Toto1271/RedMachine2025-OFICIAL/v-photos/arriba.jpg

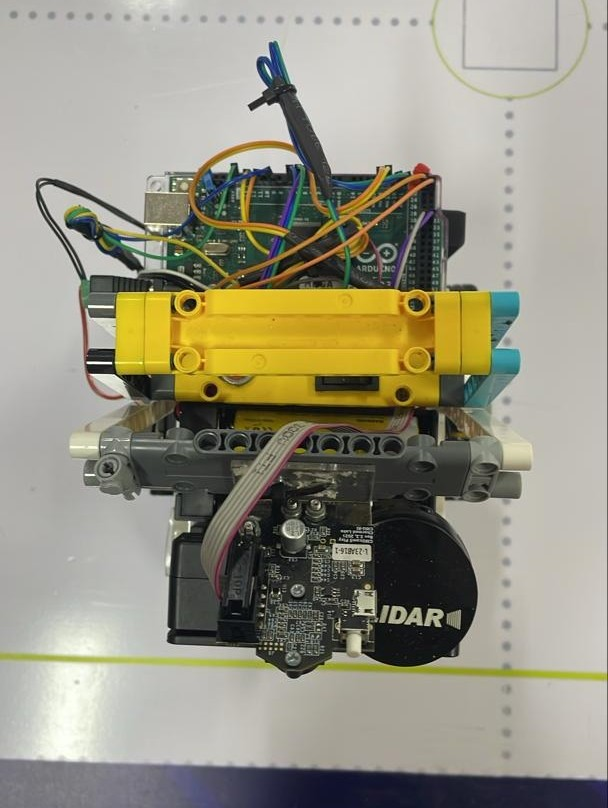
v-photos/arriba.jpg
