Toto1271/RedMachine2025-OFICIAL/v-photos/atras.jpg

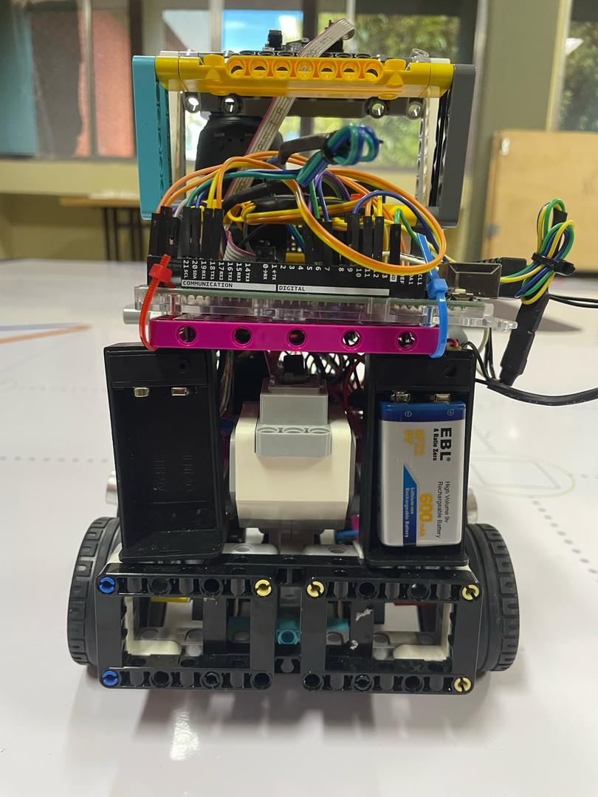
v-photos/atras.jpg
