Toto1271/RedMachine2025-OFICIAL/otros/diagrama de coneccion motores.png

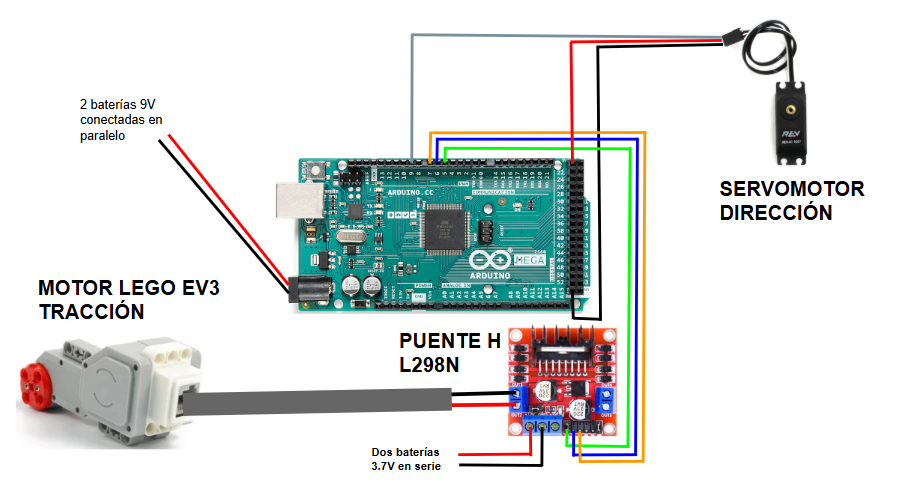
otros/diagrama de coneccion motores.png
