Toto1271/RedMachine2025-OFICIAL/otros/diagrama de coneccion sensores.png

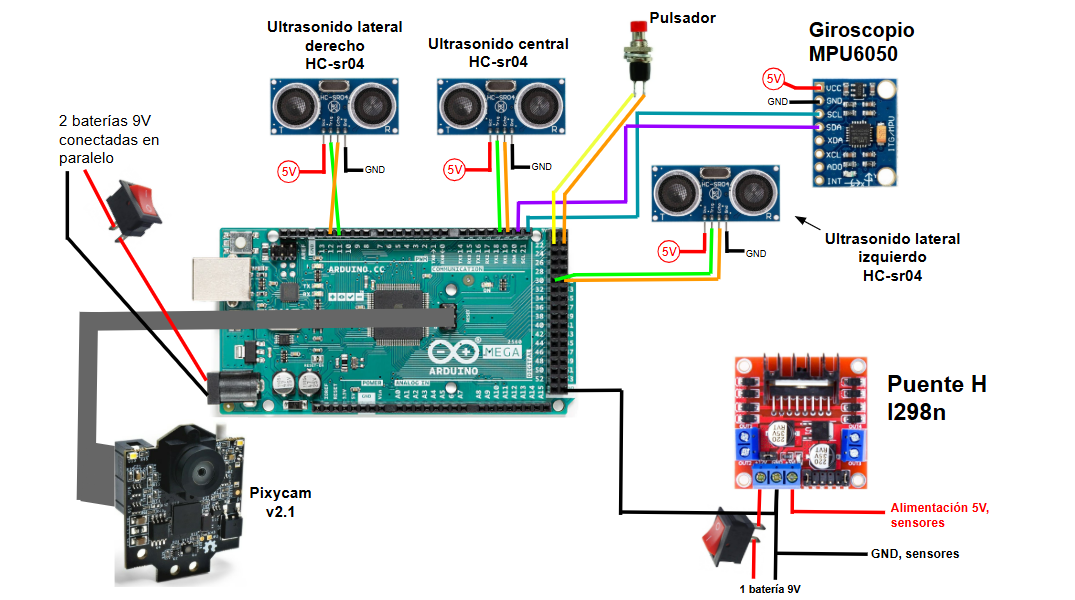
otros/diagrama de coneccion sensores.png
