Toto1271/RedMachine2025-OFICIAL/otros/diagrama pixycam.jpeg

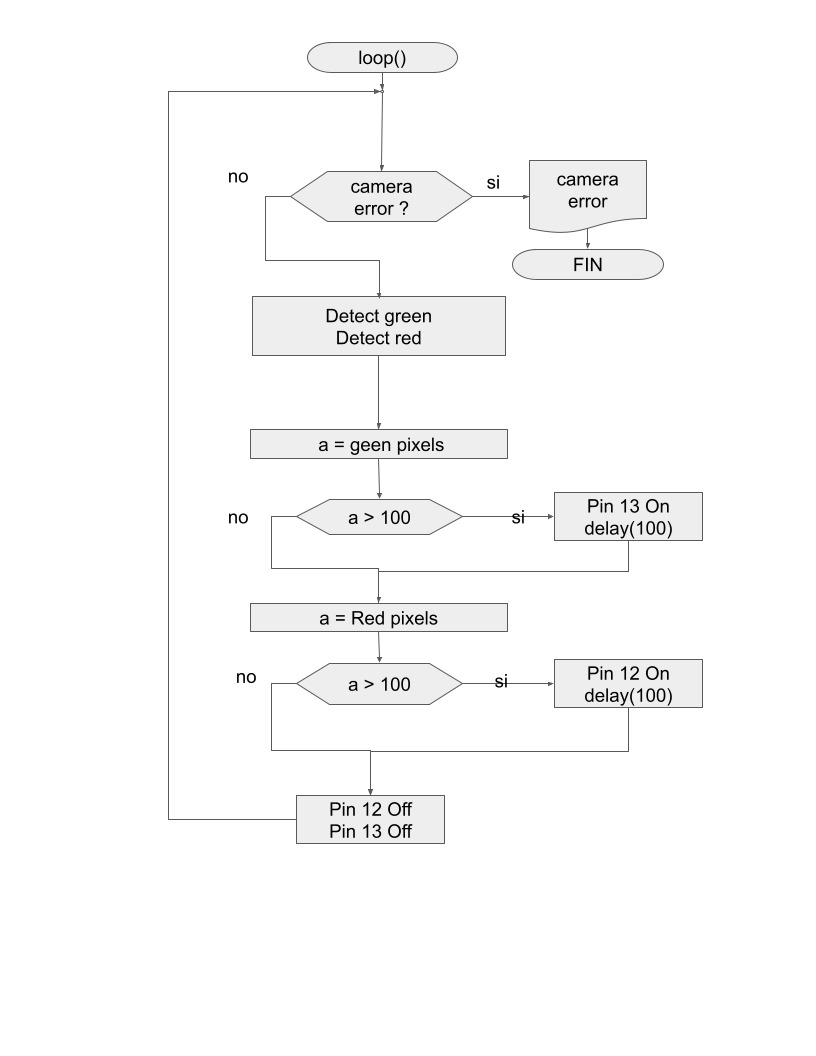
otros/diagrama pixycam.jpeg
