Toto1271/RedMachine2025-OFICIAL/t-photos/2023_Panama_International_final.png

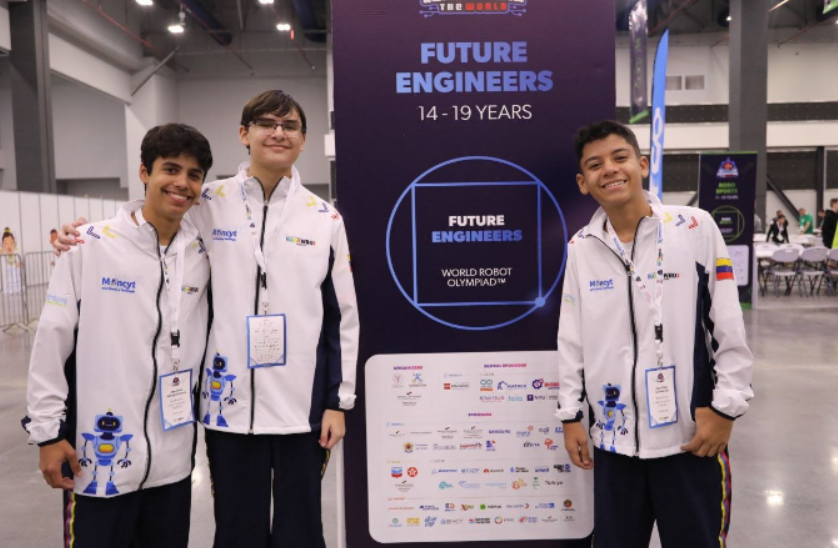
t-photos/2023_Panama_International_final.png
