Toto1271/RedMachine2025-OFICIAL/t-photos/Funny_Foto_2024.jpg

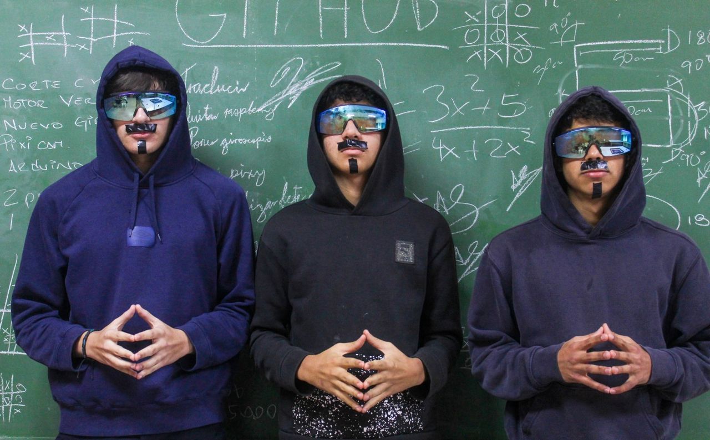
t-photos/Funny_Foto_2024.jpg
