Toto1271/RedMachine2025-OFICIAL/t-photos/Team_photo.png

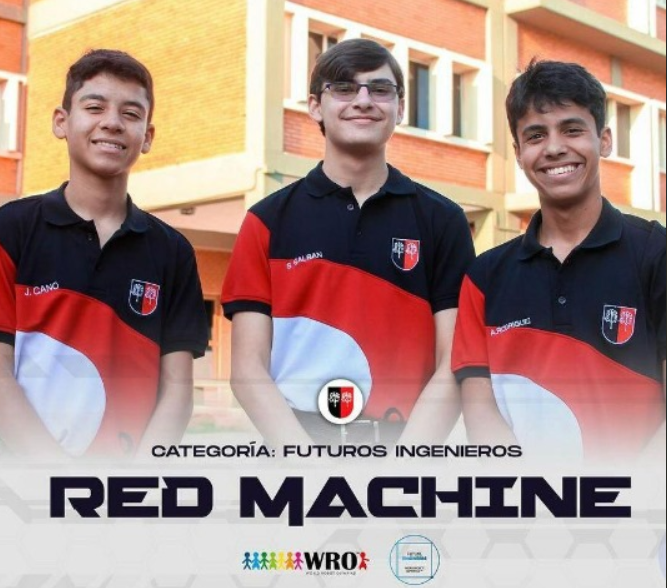
t-photos/Team_photo.png
