Toto1271/RedMachine2025-OFICIAL/v-photos/debajo.jpg

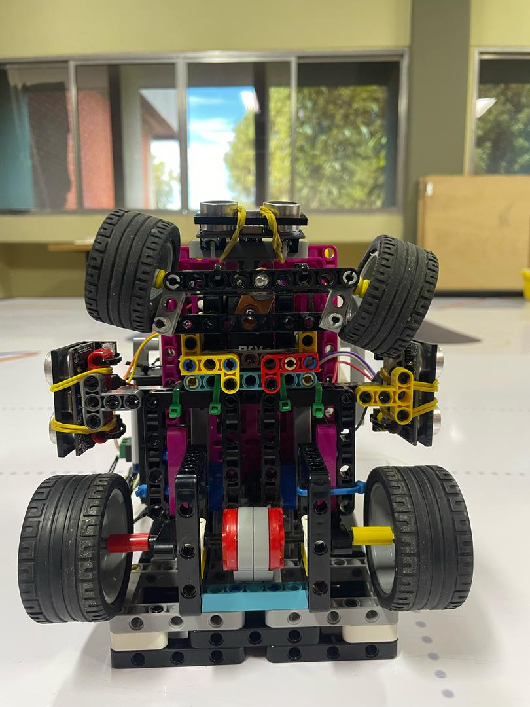
v-photos/debajo.jpg
