Toto1271/RedMachine2025-OFICIAL/v-photos/frontal.jpg

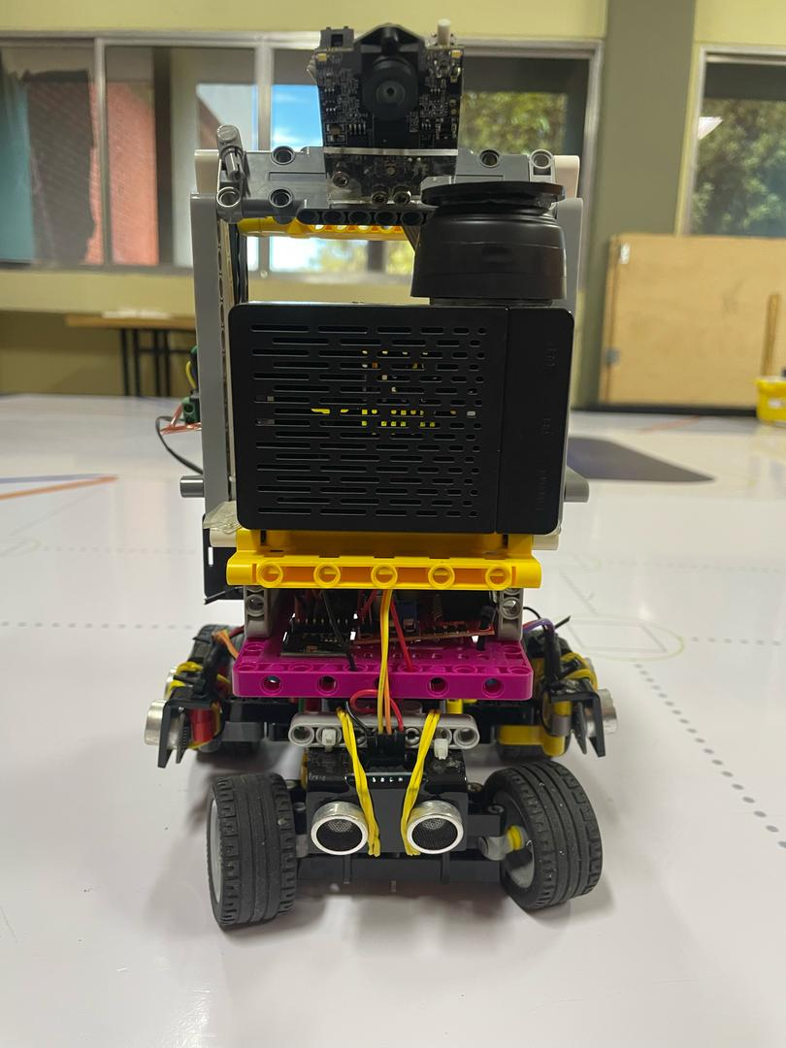
v-photos/frontal.jpg
