Toto1271/RedMachine2025-OFICIAL/v-photos/lateral derecho.jpg

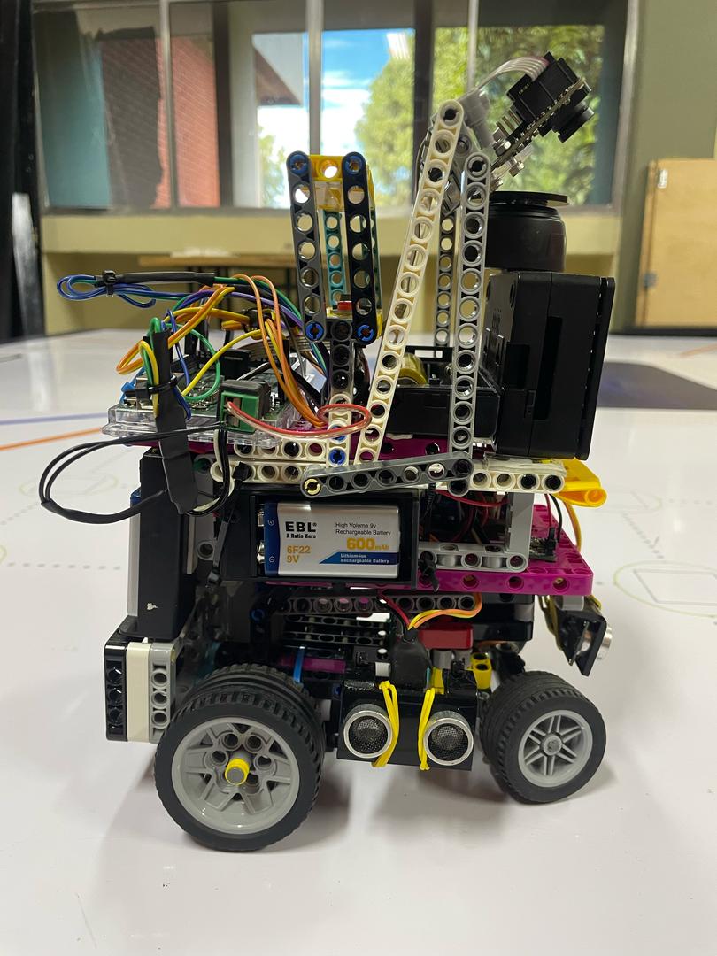
v-photos/lateral derecho.jpg
