Toto1271/RedMachine2025-OFICIAL/v-photos/lateral izquierdo.jpg

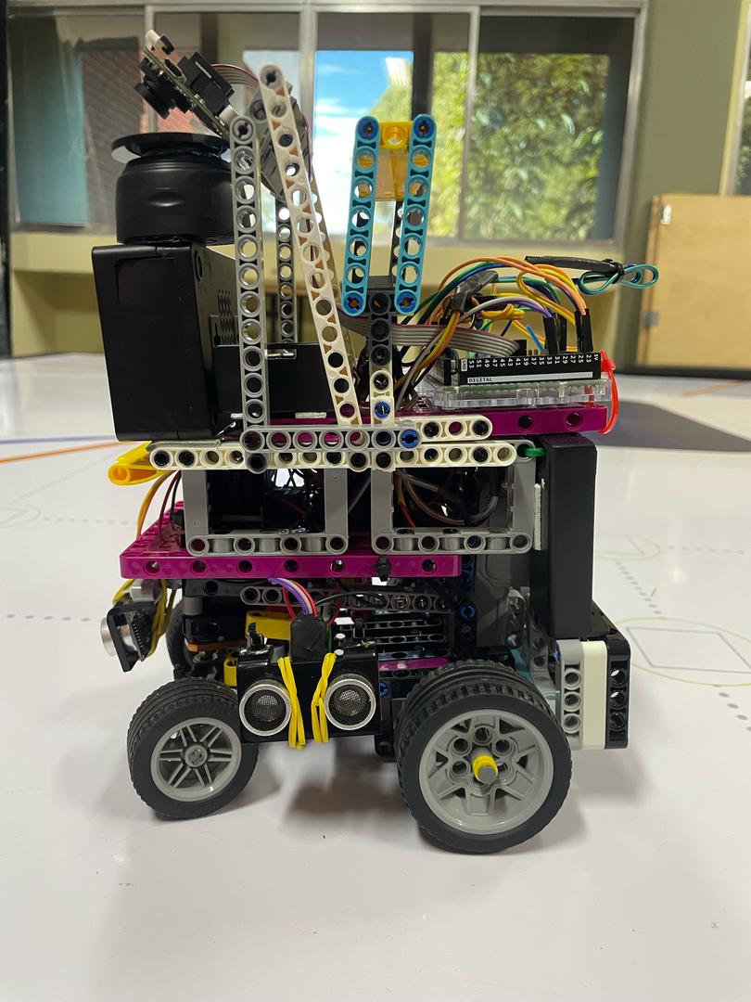
v-photos/lateral izquierdo.jpg
