Toto1271/RedMachine2025-OFICIAL/(commit log)

2025-08-27 se arreglo la u en saúl
2025-08-27 se termino de arreglar la ú en saúl
